LSC-Labs/OnAir-Light/doc/resources/Hardware1.png

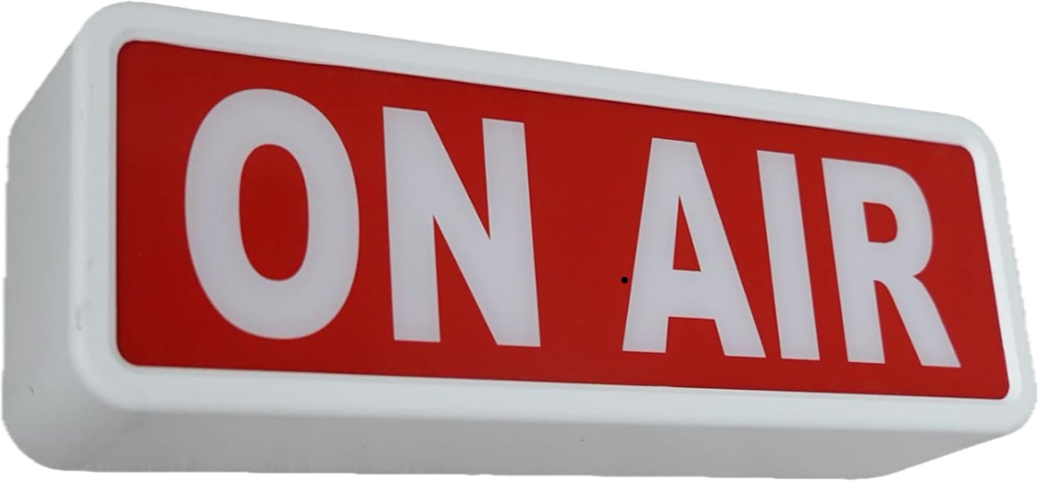
doc/resources/Hardware1.png
