LSC-Labs/OnAir-Light/doc/resources/Halterung Stripe.stl

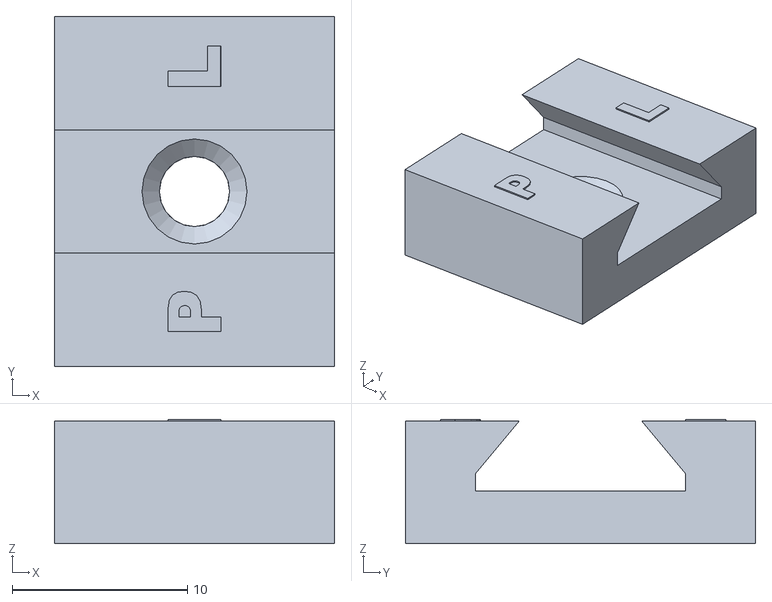
[picture p4: CAD file, 2026-11-09]
doc/resources/Halterung Stripe.stl
16.0 x 20.0 x 7.10
