LSC-Labs/OnAir-Light/doc/resources/Ledclip.STL

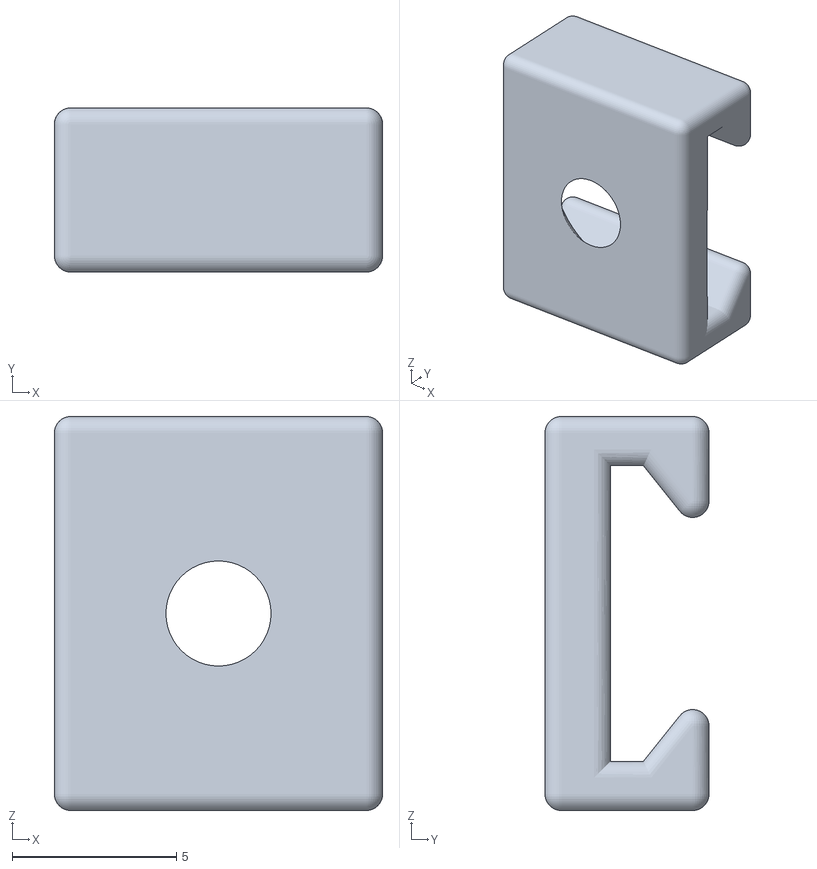
[picture p5: CAD file, 2026-11-09]
doc/resources/Ledclip.STL
10.0 x 5.00 x 12.0
