LSC-Labs/OnAir-Light/include/ProgVersion.h

#pragma once
// (c) LSC Labs
// This file will be build by the runtime, so do not change here.
// If you want to change the major/minor/patch version nummer, use the file data/prog_ver.json.
// The build nummer will be incremented in this file by platform.io -> prebuild steps

#define PROG_VERSION_NAME  "OnAir Light"
#define PROG_AUTHOR        "LSC Labs - P.Liebl"
#define PROG_HOMEPAGE      "https://github.com/lsc-labs/OnAir-Light#readme"

#define PROG_VERSION_MAJOR 2
#define PROG_VERSION_MINOR 5
#define PROG_VERSION_PATCH 1
#define PROG_VERSION_BUILD 1
#define PROG_VERSION       "2.5.1"
#define PROG_VERSION_SHORT "2.5"
#define PROG_VERSION_LONG  "2.5.1.1"
