LSC-Labs/OnAir-Light/src/CStatus.cpp

#ifndef DEBUG_LSC_ONAIRLIGHT
    #undef DEBUGINFOS
#endif
#include <Status.h>
#include <AppMsgs.h>
#include <DevelopmentHelper.h>


int CStatus::receiveEvent(const void * pSender, int nMsgType, const void *pMessage, int nMsgInfo) {
    switch(nMsgType) {
        case MSG_REBOOT_REQUEST: isRebootPending = true; break;
        case MSG_BUTTON_ON     : isButtonPressed = true; DEBUG_INFO("--- button ON"); break;
        case MSG_BUTTON_OFF    : isButtonPressed = false; DEBUG_INFO("--- button OFF");break;
        // case MSG_SET_RESTART_WIFI  : restartWiFi     = nClass == WIFI_RESTART_OFF ? false : true; break;
        case MSG_SCAN_RF433    :            // legacy application message
        case MSG_RF433_SCAN    : {          // sent by CWebSocket ("scanRF433" command)
            DEBUG_INFO("--> STATUS message for SCAN RF433 received...");
            const AsyncWebSocketClient *pClient = (const AsyncWebSocketClient *) pMessage;
            ScanRF433RequestorId = pClient ? pClient->id() : 0;
            break;
        }
    };
    return(EVENT_MSG_RESULT_OK);
}

void CStatus::writeStatusTo(JsonNode &oStatusNode, int nLevel) {
    oStatusNode["rebootPending"] = isRebootPending;
    oStatusNode["ButtonPressed"] = isButtonPressed   ? "1" : "0";
    // oStatusNode["RestartWiFi"]   = restartWiFi       ? "1" : "0";
    #ifdef DEBUGINFOS
        oStatusNode["DebugMode"]     = "1";
    #else
        oStatusNode["DebugMode"]     = "0";
    #endif
}
