LSC-Labs/OnAir-Light/(commit log)

2025-04-09 Typ of coax inserted
2025-06-01 Fixed: - Error in static ip handling - GUI improvements
    [ProgVersion.h]
2025-06-01 Static Address fix, GUI enhancements...
    [ProgVersion.h]
2025-06-06 Fix: Static IP and timeout error
    [COnAirLight.cpp, OnAirLight.h, ProgVersion.h, main.cpp]
2025-07-09 Typo corrected, Timeout corrected
    [OnAirLight.h, ProgVersion.h]
2025-07-10 Timeout fixed until not configureable to 12h
    [COnAirLight.cpp, ProgVersion.h]
2026-03-14 power to voltage corrected
    [ProgVersion.h]
2026-07-10 bug fix name of client in status info
    [COnAirLight.cpp, ProgVersion.h]
2026-07-12 corrected nested css error in gulp processing (minimizing)
    [ProgVersion.h]
2026-07-12 Battery and WiFi HomeAssistant AutoDiscovery feature
2026-11-09 STL and Hardware
2026-11-11 Version 2.5.0.2 - second ESPAsyncTCP abort() fix
    - patchLibs.py v2: AsyncClient::abort() now returns ERR_ABRT to lwIP when
    called inside a lwIP callback (freed pcb was used after tcp_abort()).
    Fixes hangs / hardware watchdog resets under port scans.
    - PLibESPV1 updated (patchLibs.py synced)
    - doc: issue text and diff for ESPAsyncTCP / ESPAsyncWebServer
